AguaClara/sensor_dev/README.md

# sensor_dev
The sensor development team's repo.

## Current Team Members
* Winnie Chan (wc436@cornell.edu)
* Payton Hunter (prh64@cornell.edu)
* Kaleigh Soucy (krs258@cornell.edu)
* Sanjana Uddin (ssu3@cornell.edu)

## Semester Goals
<!---Our goal is to create a lowcost but efficient concentration detector by essentially hijacking cheap endoscopes/borescopes and merging its function with code and physical additions of our own. By designing a mobile application that utilizes image processing and basic equations relating the image values to concentrations, we can both get a visual of what is going on in each level of depth and determine using a threshold value where the sludge blanket begins.--->
Our goal is to create low-cost water quality analyzing sensors for lab and field use. Two projects currently being developed are the sludge judge sampler to measure sludge blanket height in the floc hoppper and the low-cost turbidimeter. The basic function of this sensor is to relate absorbance or image values to concentrations in order to determine the concentration of dissolved organics in the water.

## Links to Reports and Presentations
* Spring 2020
  * Future Mid-Semester Symposium

* Fall 2019
  * [Mid-Semester Symposium](https://docs.google.com/presentation/d/1IKnD7iTeREiuXIxk95GRojf3bocVBwtAz84cADMnMpM/edit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)

* Spring 2019
  * [Final Presentation Video](https://www.youtube.com/watch?v=eXQLOUvBqTo&list=PLhsGtpY8ipdZL4lExJA8KC0zCkaxwfs8R&index=14&t=0s)

  * [Midterm Symposium](https://docs.google.com/presentation/d/19i2A-b2Q4f15zrK7iW6RqBcvtl5FQ7Lq-mFPZDGoYFw/edit?usp=sharing)

  * [Final Presentation](https://docs.google.com/presentation/d/18_G2b-PVCcobUceRZrm6Su0W9RKVEnH4eKmfyDdSLxM/edit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)

  * [Final Manual](https://github.com/AguaClara/sensor_dev/blob/master/Spring%202019/Sensor%20Development%20Spring%202019.md)

* Fall 2018
  * [Final Presentation Video](https://www.youtube.com/watch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)

  * [Midterm Symposium](https://docs.google.com/presentation/d/1lunibmZEZ28jcir-08SKcnAh3Tq5pmKuoBBsQUrALIY/edit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)

  * [Final Presentation](https://docs.google.com/presentation/d/17gbcGkgXVKzlnCITjcyJOvZCZV-m2hfEmijmOgN-dpk/edit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)

  * [Final Manual](https://github.com/AguaClara/sensor_dev/blob/master/2018_fall/Sensor%20Development%20Fall%202018.md)

* Spring 2018
  * [Midterm Symposium](https://docs.google.com/presentation/d/1DQyx87q7LtW5yOaPytrrnAvyGNLM-DLOTYY6XjQVZQw/edit?usp=sharing)

  * [Final Presentation](https://docs.google.com/presentation/d/1z8MEi4Bpe6GwdDxDbs89RpllG_0ilBI8o5UYnoSLq9U/edit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)

  * [Final Manual](https://github.com/AguaClara/sensor_dev/blob/master/manuals/manual_1.md)
