AguaClara/sensor_dev/parser_for_roster/README.txt

1.  please put the file to parse into the current folder

2.  open the terminal and cd into the current folder

3.  use the following command:
        'python3.7 name_organizer.py'

4. follow the prompts

NOTE: you may need to download the xlrd library by inputting the following command
      into the terminal:
        'pip install xlrd'
