AguaClara/sensor_dev/2018_fall/MIA_MAPE.jpg

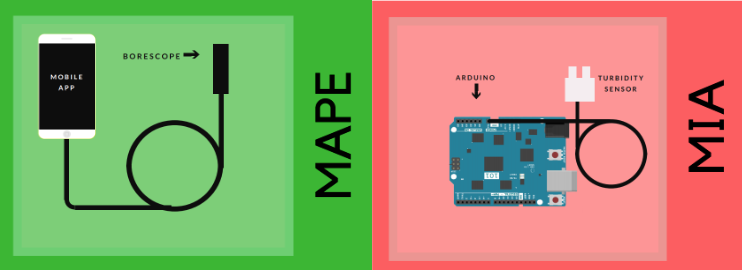
2018_fall/MIA_MAPE.jpg
