AguaClara/sensor_dev/Fall 2019/IR Sample Cell.png

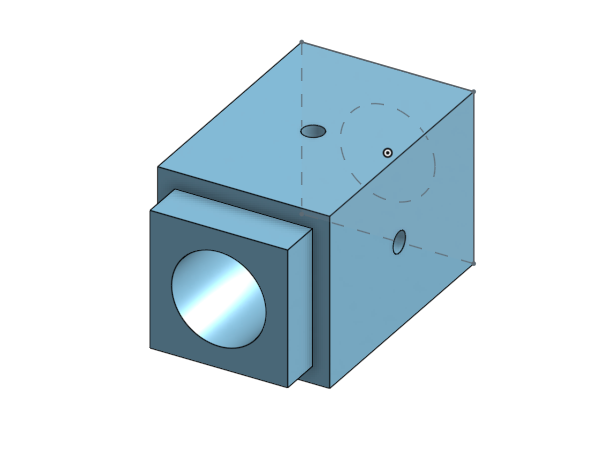
Fall 2019/IR Sample Cell.png
