AguaClara/sensor_dev/Fall 2019/kaolinclayreadings.png

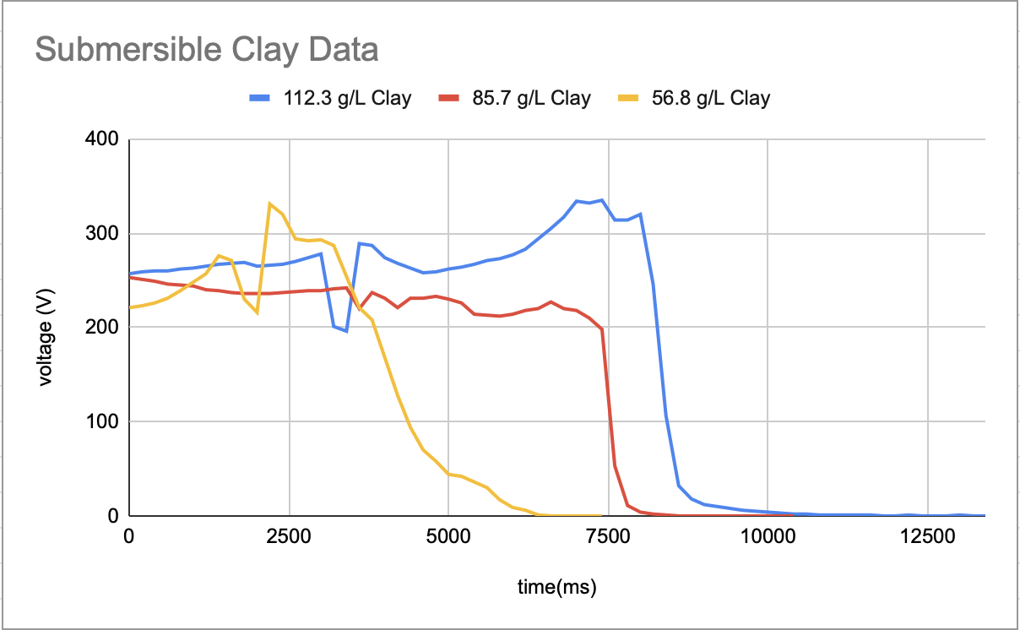
Fall 2019/kaolinclayreadings.png
