AguaClara/sensor_dev/Fall 2019/LEDCircuit.png

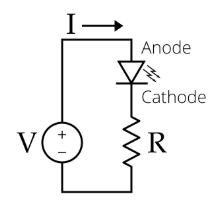
Fall 2019/LEDCircuit.png
