AguaClara/sensor_dev/Fall 2019/oldsubmersibleprototype.png

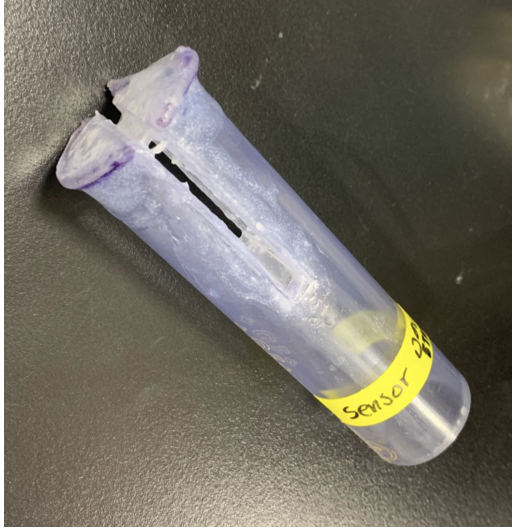
Fall 2019/oldsubmersibleprototype.png
