AguaClara/sensor_dev/Fall 2019/PhototransistorDiagram.png

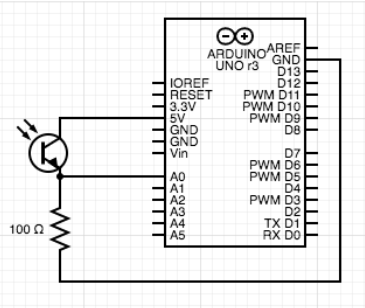
Fall 2019/PhototransistorDiagram.png
