AguaClara/sensor_dev/Fall 2019/RGB Sample Cell.png

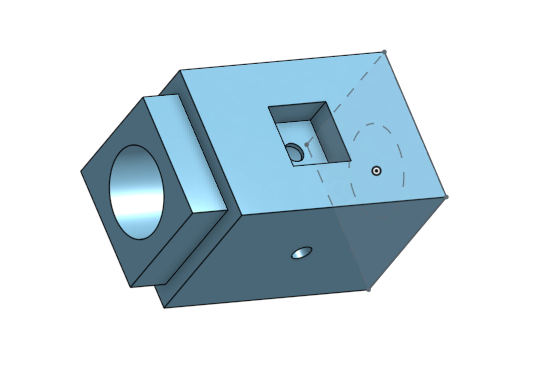
Fall 2019/RGB Sample Cell.png
