AguaClara/sensor_dev/Fall 2019/Sample Cell Top.png

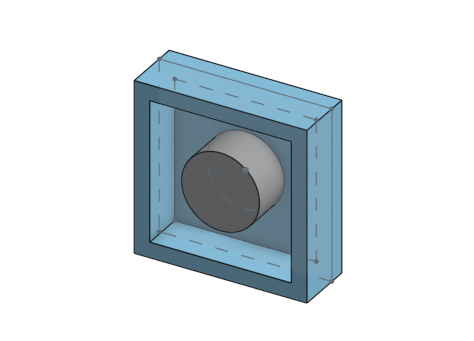
Fall 2019/Sample Cell Top.png
