AguaClara/sensor_dev/Fall 2019/Submersible Sensor.png

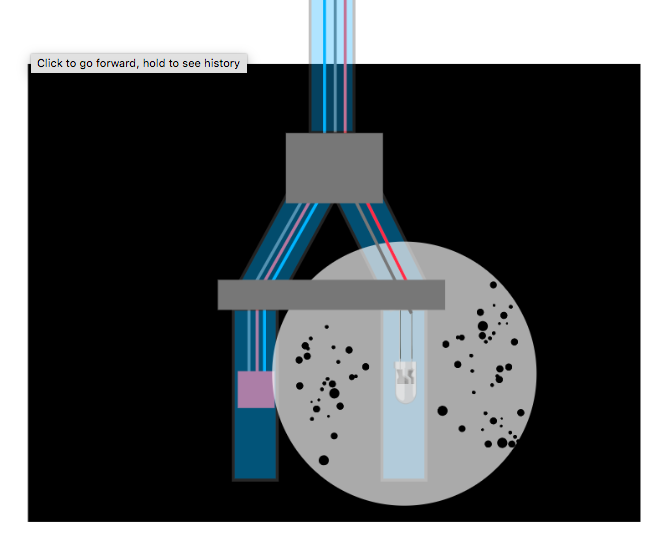
Fall 2019/Submersible Sensor.png
