AguaClara/sensor_dev/Fall 2019/submersibleCAD.png

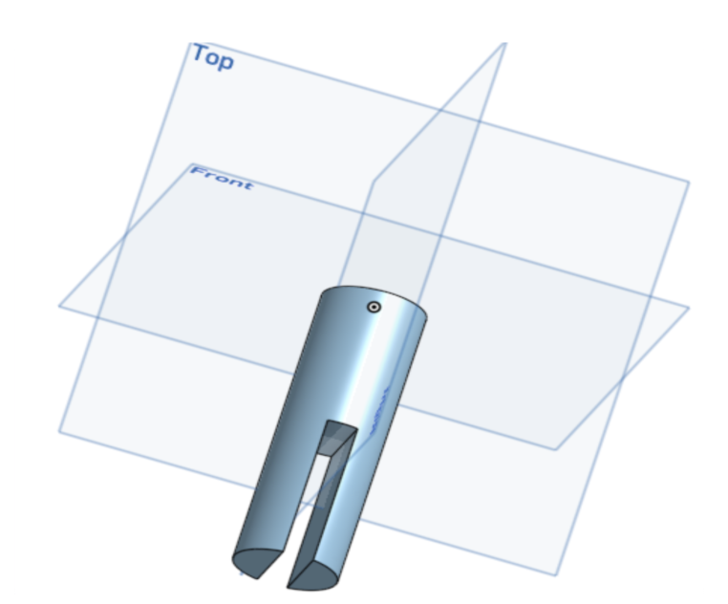
Fall 2019/submersibleCAD.png
