AguaClara/sensor_dev/Fall 2020/500mgLBlue.JPG

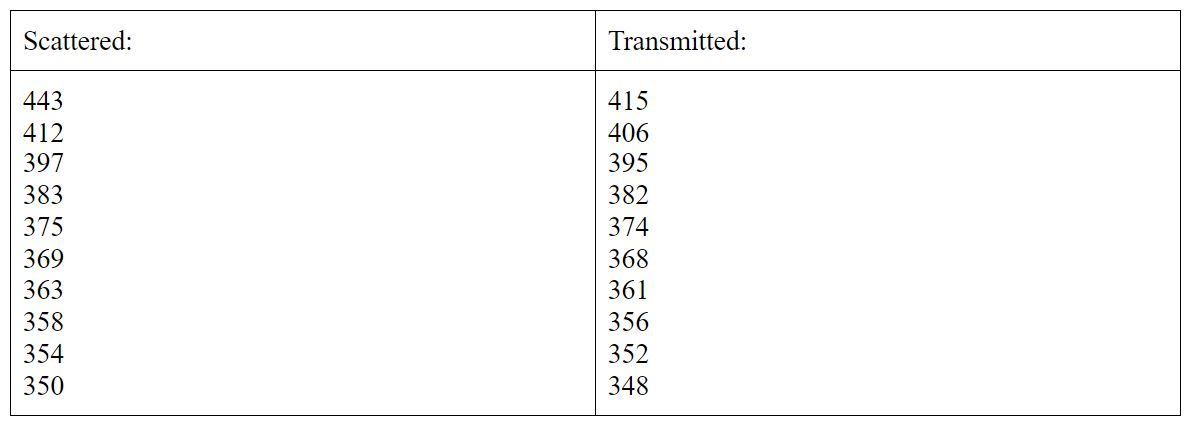
Fall 2020/500mgLBlue.JPG
