AguaClara/sensor_dev/Fall 2020/1000mgLIR.JPG

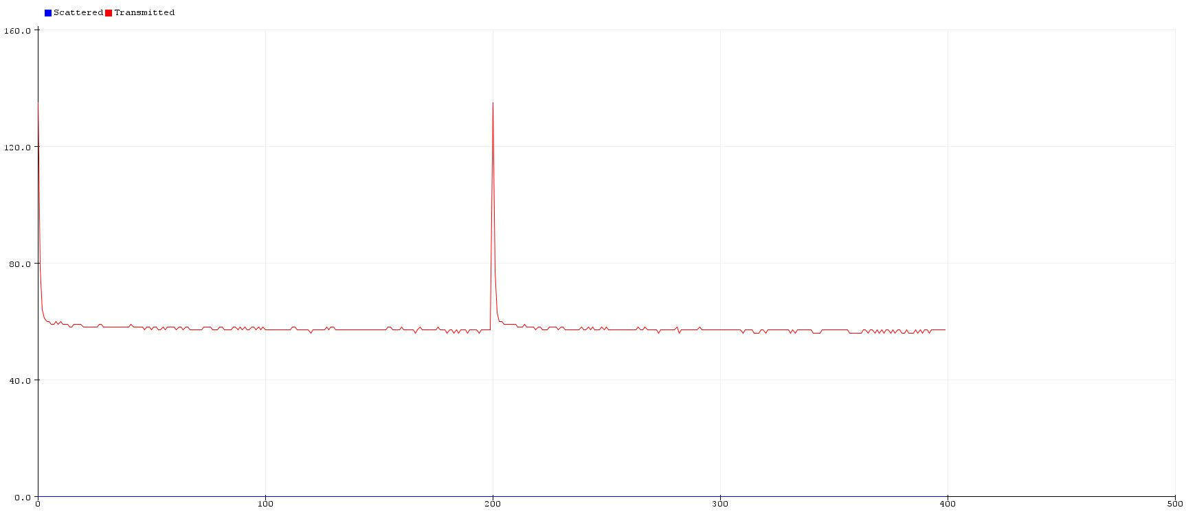
Fall 2020/1000mgLIR.JPG
