AguaClara/sensor_dev/Fall 2020/AguaClara_SludgeJudge.png

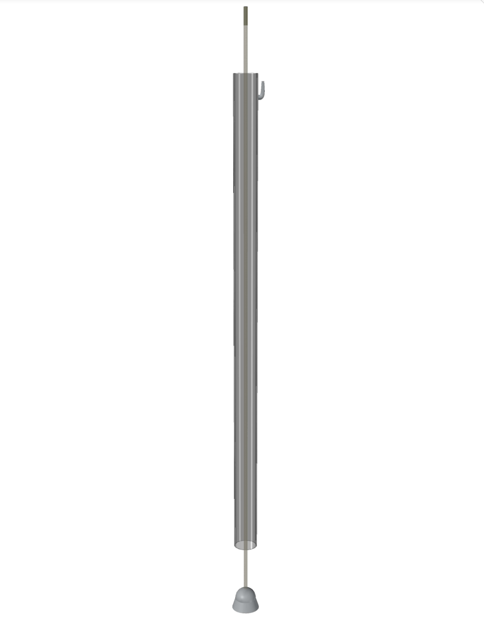
Fall 2020/AguaClara_SludgeJudge.png
