AguaClara/sensor_dev/Fall 2020/IR Sensor Data/0 mgPerL sensor data- report 3-fall 2020.PNG

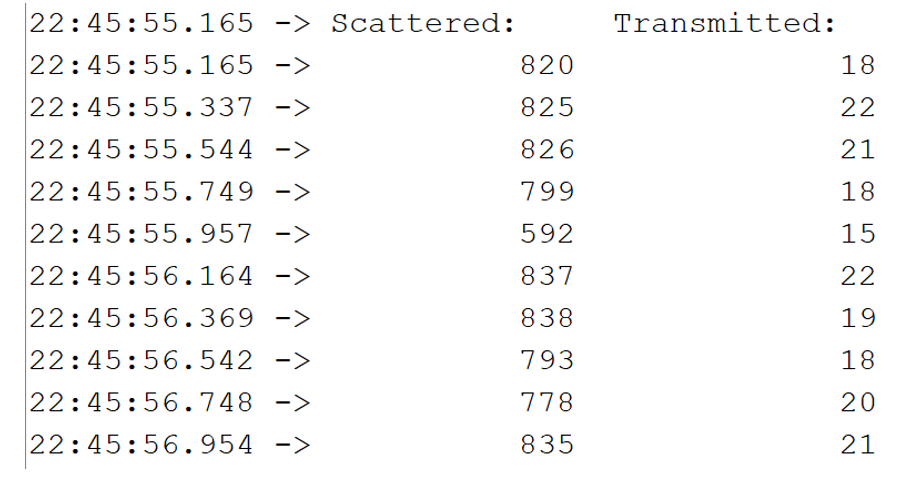
Fall 2020/IR Sensor Data/0 mgPerL sensor data- report 3-fall 2020.PNG
