AguaClara/sensor_dev/Fall 2020/Sensor Circuit.jpg

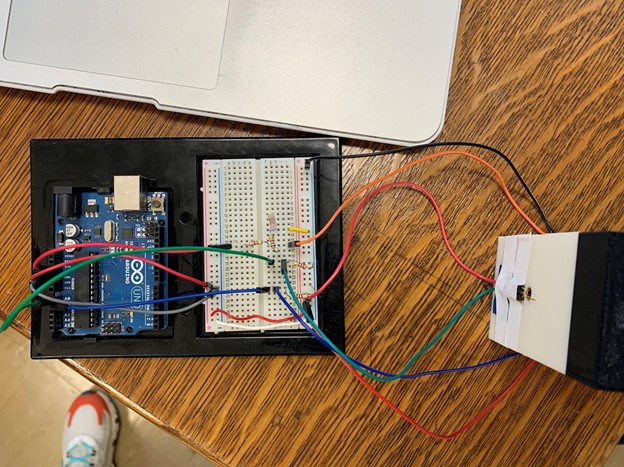
Fall 2020/Sensor Circuit.jpg
