AguaClara/sensor_dev/Fall 2020/Sludge Judge Model Design.PNG

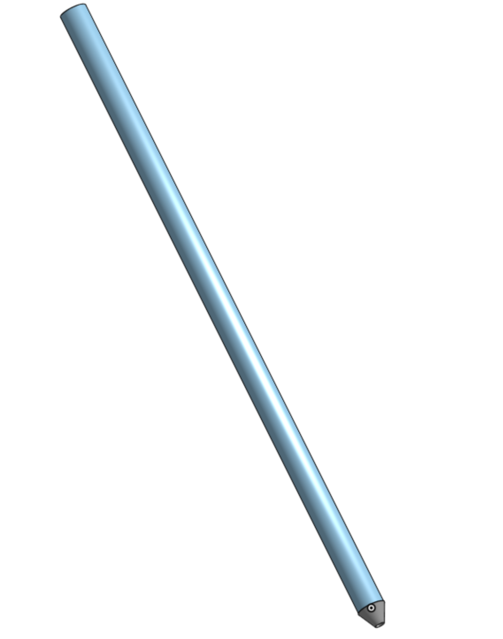
Fall 2020/Sludge Judge Model Design.PNG
