AguaClara/sensor_dev/Newmodelsub.jpg

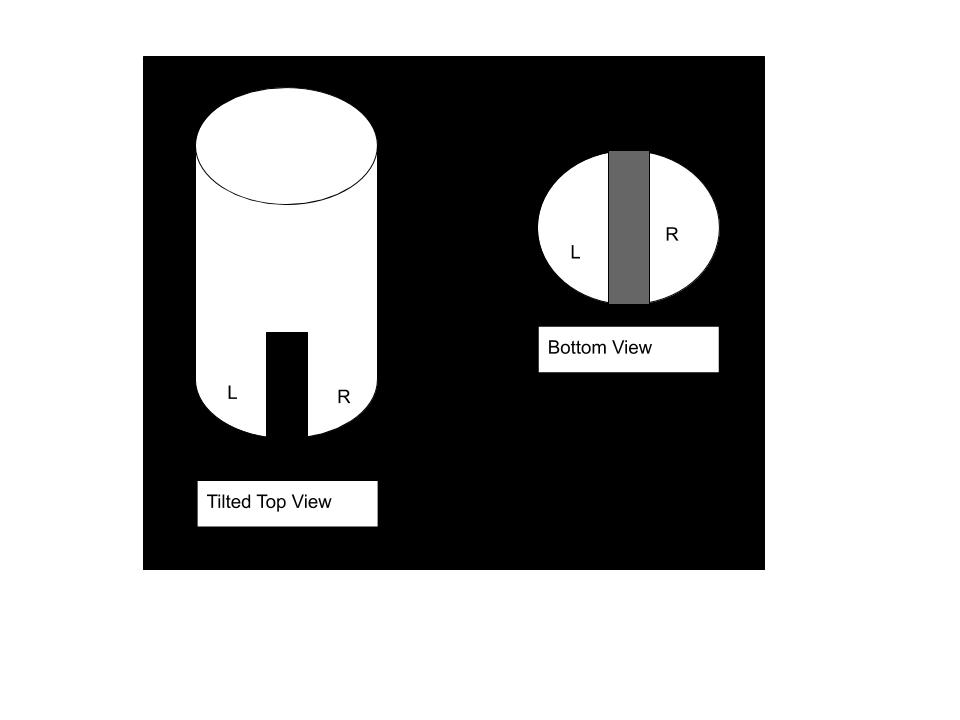
Newmodelsub.jpg
