AguaClara/sensor_dev/Spring 2020/SUBMERSIBLE.png

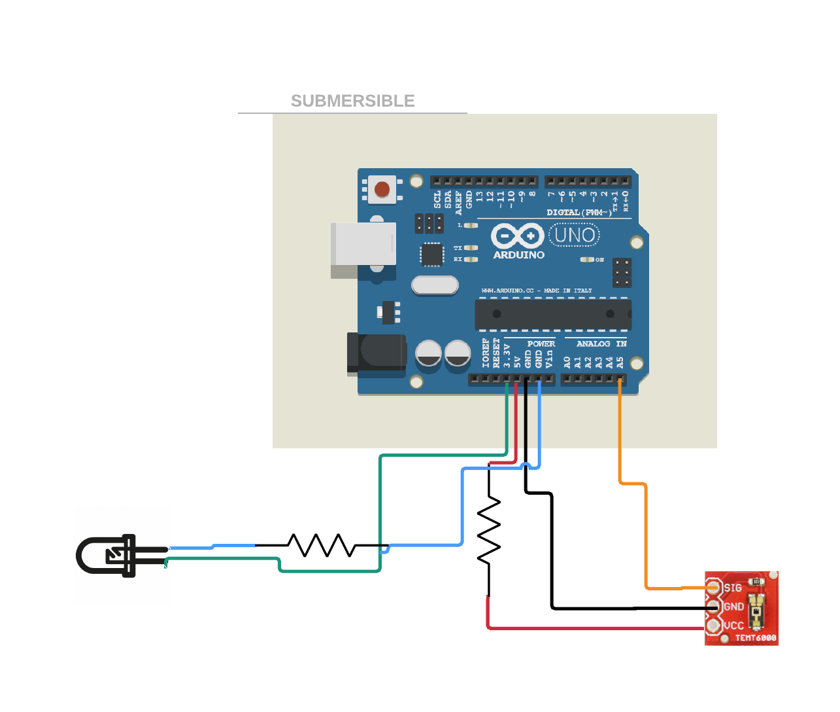
Spring 2020/SUBMERSIBLE.png
