AguaClara/sensor_dev/Fall 2019/DOSensorSetup.jpg

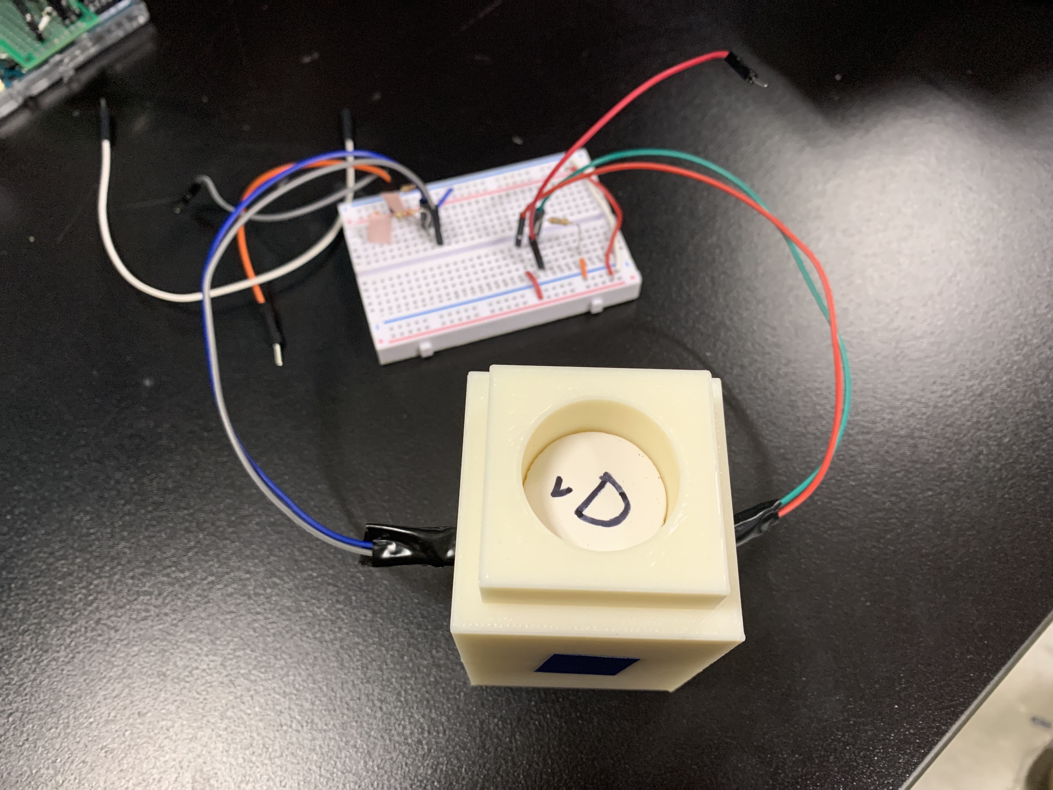
Fall 2019/DOSensorSetup.jpg
