AguaClara/sensor_dev/Fall 2019/submersibleTestingApparatus.png

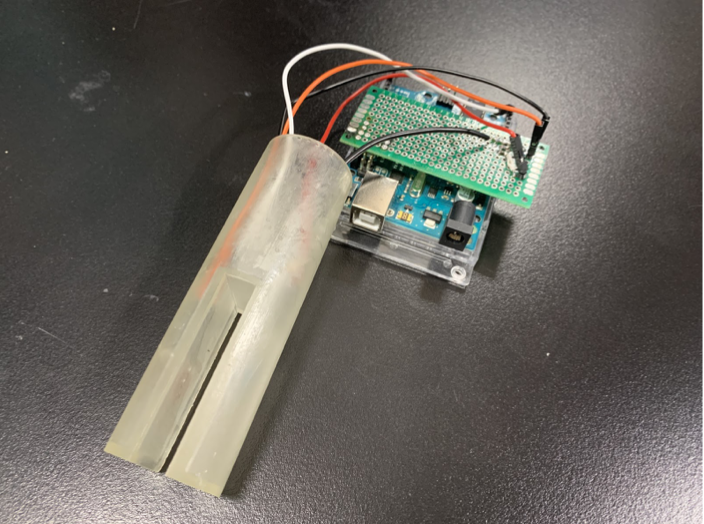
Fall 2019/submersibleTestingApparatus.png
