AguaClara/sensor_dev/(threads)

Thread 10 (2018-02-22):

Test UI[Test the UI for the endoscope sensor]

lois-lee, 2018-02-22:

HannahSi, 2018-05-17:
We currently have two programs: one is run on a computer and streams the computer's own camera or an external camera (the endoscope, connected by USB) while calculating average light intensity of the video frames; the other is an Android app that currently streams feedback from the phone's own camera(s) with constant exposure.

The two functionalities still need to be integrated into the smartphone app. This has been more difficult because the Android libraries cannot directly access external cameras. Instead, we are considering using the OpenCV library (which we will use anyway for image processing) or a third party library (see https://stackoverflow.com/questions/37828376/android-open-external-uvc-camera-instead-hardware-camera) to communicate with the endoscope camera.

HannahSi, 2018-05-17:
As for the GUI, below are functionalities to include:
Need/Strongly want:
- The turbidity of the fluid currently surrounding the endoscope
- A scaled-down live video from the endoscope
- An indication of whether the endoscope has entered the sludge blanket
Want:
- A number-picker/dial for the user to input the depth of the endoscope (known by the expandable ruler used to lower the endoscope)
Wish:
- An option to see a graph of turbidity plotted against depth
- The ability to save such graphs ("turbidity profiles") for each run
- A main menu page where the user can choose to start a new run or view past profiles

HannahSi, 2018-05-17:
As for the GUI, below are functionalities to include:
Need/Strongly want:
- The turbidity of the fluid currently surrounding the endoscope
- A scaled-down live video from the endoscope
- An indication of whether the endoscope has entered the sludge blanket
Want:
- A number-picker/dial for the user to input the depth of the endoscope (known by the expandable ruler used to lower the endoscope)
Wish:
- An option to see a graph of turbidity plotted against depth
- The ability to save such graphs ("turbidity profiles") for each run
- A main menu page where the user can choose to start a new run or view past profiles

HannahSi, 2019-02-07:
@ll678 I think my first comment in this issue is a good explanation of progress and next steps I talked about today. Basically, the mobile app still needs to
1) Access and display images from an external camera, i.e. the endoscope
     * Maybe use OpenCV, which we used to access the camera in the Endoscope Pilot Code project
2) Process those images for average light intensity
     * See the [averageLight function](https://github.com/AguaClara/sensor_dev/blob/master/code/Endoscope%20Pilot%20Code/EndoscopeFrame.java#L72-L90) in EndoscopeFrame.java in the Endoscope Pilot Code project)

I'm currently working on documenting the mobile app code. When I'm done, would you like me to send it to you or contribute it to the repository?

ll678, 2019-02-07:
@HannahSi  You can contribute the documentation to the repository. Thank you!

Thread 3 (2018-02-22):

Fabrication [fabricate the parts necessary for the turbidity sensor and the endoscope sensor]

lois-lee, 2018-02-22:
[fabricate the parts necessary for the turbidity sensor and the endoscope sensor]

lois-lee, 2018-02-27:
We've been working so far on waterproofing the turbidity sensor by sealing PVC to the top of the sensor and then using more flexible tubing for the wiring.

For the Borescope, we've realized that the design will depend heavily on a lot of variables which have to be tested, so we have to test it in an environment similar to the floc hopper and then begin fabrication.

hs649, 2018-03-01:
The prototype of the waterproof casing is near finished.
The variables include the reflectivity of the container and of the sediment. It would be helpful to know these characteristics of the floc hopper, but for now our goal is to gauge the consistency of the borescope feedback while those factors are eliminated as much as possible, such as with a very large and/or matte container and dark sediment.

HannahSi, 2018-03-06:
Forgot to post this last week. We finished fabrication of the turbidity sensor casing, shown in the picture attached. For some reason though, when we tested the encased and uncased sensors on Thursday, neither seemed to working properly--their values didn't fluctuate enough with changes in light. We're going to test and troubleshoot the uncased turbidity sensor first to see if it's poor connections or something else.

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

vsrilekha, 2018-05-17:
We have discontinued using this analog turbidity sensor and have opted to use an LED instead.

Closed 2018-05-17.

Thread 4 (2018-02-22):

Programming [programming in C for the turbidity sensor and programming in Java for the mobile/website app]

lois-lee, 2018-02-22:

lois-lee, 2018-02-27:
Preliminary coding for the turbidity sensor is finished, we just need to figure out a reliable relation and then test.

Coding for the mobile application is in the works. We are using OpenCV.

hs649, 2018-02-28:
I installed OpenCV for Java on my computer and am having trouble adding the library's "external JAR" to Eclipse. I was hoping to write a basic program for computing average grayscale to help with testing the precision of the endoscope images. If we're testing this week, we may have to find another temporary method of computing this.

hs649, 2018-03-01:
The OpenCV library is now working in Eclipse! Currently looking into ways to collect and display camera feedback without involving too much third party software.

HannahSi, 2018-03-15:
Just committed Java code for viewing the endoscope video in a computer and obtaining its camera settings. I tried to modify certain settings so that we can hold the gain and exposure constant, but so far it has been unsuccessful. Maybe it's a deficiency of the Java OpenCV library, maybe I need to use another part of it.

HannahSi, 2018-03-17:
It seems like OpenCV can't change the camera parameters for this USB camera (perhaps because the camera is not advanced enough; it also doesn't work with my computer's built-in webcam). However, when I search "Java set camera parameters", there seems to be more documentation for doing so with the Java Android libraries. So maybe we should try figuring it out directly through app programming?
Also, I wrote some code that averages the light intensity value of every pixel in the camera image. Next step is to see how sensitive it is to small spots of light against a black background (if it's not sensitive enough we could probably square/exponentiate the values).

HannahSi, 2018-03-20:
Came across this error while running the endoscope code: `Exception in thread "AWT-EventQueue-0" java.lang.IllegalArgumentException: Width (0) and height (0) must be > 0`. It seems there are two cases in which this occurs:
1. The camera could not be found. This should be accompanied by an error at the very beginning saying `OpenCV: out device of bound (0-0): 1 \ OpenCV: camera failed to properly initialize!`. Since I could see that my computer itself could detect the USB camera ( > About This Mac > System Report > USB), I restarted my computer and the problem was resolved (mostly, see next case).
2. The error also occurs if the endoscope image is completely black. We may not be able to achieve full blackness with the LEDs on, but if this is an issue hopefully we can correct it programmatically.

Closed 2018-05-17.

Thread 5 (2018-02-22):

Testing Function [testing the code's function for turbidity sensor]

lois-lee, 2018-02-22:

lois-lee, 2018-03-08:
The sensor's are not fluctuating as much as they should be, so we need to troubleshoot the sensor. We're not sure if they are broken or if it's a connection problem.

Closed 2018-05-17.

Thread 6 (2018-02-22):

UI [make a user interface for the turbidity sensor using a digital screen]

lois-lee, 2018-02-22:

lois-lee, 2018-03-16:
added some code using liquid crystal display library from arduino for a possible interface.

Thread 12 (2018-02-27):

Github Issues Check #1

caseyching13, 2018-02-27:
See the rubric that was shared with you earlier in the semester for your Team's grade.

-Good detailed logbook on Sensor Dev’s website. Would it be possible to try to switch over to Github to track progress as opposed to documenting it on the website?

The following should be on Github issues:
-Problems/questions that come up
-Discussion on said problems (it would allow Ethan and Monroe to give feedback and to see your team’s progress)
-Pictures! I would love to see how the Arduino board is coming along
-Make sure all team members are participating on Github!
-Don’t forget to track meetings on Github
-Please incorporate suggestions into future Github usage
-The next Github issues check will be in 2 weeks!

Closed 2018-05-17.

Thread 15 (2018-03-21):

Github Issues Check #2

caseyching13, 2018-03-21:
See the rubric that was shared with you earlier in the semester for your Team's grade.

-Github issues are thorough! I like how questions are posed and subsequently answered as the problems are figured out
-Good use of pictures
-Is there any reason why @vsrilekha isn’t participating on Github?
-The team can close issues as necessary (including the meeting #1 and Github issues check #1)
-Huge improvement from Issues check #1!

-Next Issues check will be after Spring Break
-Feel free to contact me with questions!

Closed 2018-05-17.

Thread 17 (2018-04-11):

Light gain issue resolved

lois-lee, 2018-04-11:
When we talked to Monroe we were trying to see if we could adjust and turn off light gain. We don't think it's resolvable by programming so we're going to cover one half of it up and then use it as a control to manually determine the light gain factor

HannahSi, 2018-05-16:
The light gain issue is actually close to being resolved programmatically! The Android camera library used in the Android app code (see sensor_dev/code/AguaClara Turbidity) is able to set a constant exposure compensation for the front and rear cameras on the Android phone we tested on. We just need to find a way to access the endoscope camera through the app and make the same parameter change.

Thread 20 (2018-04-24):

Holes on DoubleHinge CAD

vsrilekha, 2018-04-24:
Having trouble lofting the holes, don't appear to be mirroring correctly

Closed 2018-05-17.

Thread 21 (2018-05-03):

MAPE Extension Design

HannahSi, 2018-05-03:
The purpose of MAPE turbidity sensor extension is to hold the non-reflective material in front of the camera lens without compromising the diffusion of particles in front of the lens. Our initial plan was to hold the material at the end of three prongs attached to the endoscope by a shaft collar, but for sturdiness, appearance, and ease of fabrication we have changed to a design involving two plates separated by standoffs. See next comments for details.

HannahSi, 2018-05-03:
Below is the design with prongs we started to implement. We chose prongs made of tempered steel for durability but did not include the shaft collar yet, because we were uncertain of how to securely attach the prongs to a metal collar. (A soldered connection would not be too weak. We considered welding but preferred this to be a last resort because of the skills and experience required.) See the "drawings" folder in our repository for a CAD rendering of this design.

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

HannahSi, 2018-05-04:
Below is the design we are currently fabricating with two plates and standoffs. Details to come tomorrow.

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

HannahSi, 2018-05-08:
Sorry I never finished posting this last week. Below is the design with two plates separated by standoffs. The plate in front of the endoscope lens serves the hold the nonreflective material, while the other plate serves to secure the entire contraption to the endoscope. We are using an endmill to cut a path into the latter plate so that the cable can pass through, and the plate can be glued to flush the base of the endoscope. Hopefully we'll have pictures of the finished extension later today.

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
<img src="https://user-images.githubusercontent.com/35944490/39766935-8309269e-52b3-11e8-9e6f-dd5852793737.jpg height=300>

HannahSi, 2018-05-08:
Fabrication notes on the standoff design:

- This design requires at least 4 standoffs, depending on their length, each with a female and male end. Two need to be cut about 1 cm from the ends to obtain just the female and male ends, and the other two are placed in between the two plates (they are the main standoffs). The latter are secured by screwing into or being screwed into the shortened female and male ends. (Alternatively, the former two can be replaced with screws and bolts if you can find the right size.)
- Next time use PVC or other plastic instead of metal for the two plates. It would be cheaper, and perhaps the plates would not become so hot when cutting.
- The standoffs we used had male ends of 5/32".
- Instead of using an endmill to cut a slot for the endoscope cable, we simply drilled a hole, then cut out the slot with a bandsaw. The diameter of the endoscope cable is 11/64".

HannahSi, 2018-05-09:
To calculate the dimensions of the plate, we first determined the optimal distance of the endoscope from the non-reflective material. This distance should minimize the area of material required (thus minimizing the overall diameter of the sensor) as well as the light reflected from the material. (A greater distance decreases light reflected but increases viewing area.) For our endoscope and with matte rubber as the non-reflective material, we estimated 1.5 cm.

We then used this distance and the FOV (field of view) angle of the endoscope, 60º, to calculate the width of the viewing area: 1.5 / √3 * 2 = 1.732 cm.

Adding extra length on two sides for the standoffs and a few millimeters of buffer space, we chose to cut a plate of 3.5 x 2 cm to hold the non-reflective material. The plate attached to the base of the endoscope has the same dimensions for symmetry.

HannahSi, 2018-05-09:
We're currently trying to figure out the best way to attach the base of the endoscope to the metal plate. We waiting on a silicone sealant we used to cure (harden), but it's white and thick and looks quite messy. Our research advisor suggested applying a ring of hot glue around the metal plate as a secure and more attractive sealing method. Sketch to come.

HannahSi, 2018-05-11:
I think any way of adhering the endoscope base to the metal as shown above (with the base sitting on the metal) is prone to detachment. Right now, the metal is hot glued around the body of the endoscope, which is probably a more secure method. This required first drilling a hole large enough for the whole endoscope to slide through.

HannahSi, 2018-05-17:
The MAPE extension has been finished, but it can be improved so that the endoscope is held more perpendicular to the non-reflective material. Right now, it is slightly angled because the hole in top metal plate was 1/16" too large, and the hot glue is not completely secure/rigid, so the endoscope is able to tilt. The problem can be solved with a smaller hole, perhaps thicker metal/PVC plates, and/or shorter distance between the two metal plates (so the tilt is less perceptible).

<img src="https://user-images.githubusercontent.com/35944490/40208396-7d711eb6-5a07-11e8-98ca-4c1ebd0df685.jpg" height=300">

Closed 2018-05-17.

Thread 22 (2018-05-17):

MIA Sensor [Future Work]

vsrilekha, 2018-05-17:
The design for the MIA sensor has changed. We are no longer using the analog turbidity sensor and are looking into using a LED and a light sensor. We used a similar setup for the fluidized bed solids detector last semester. The idea is to measure voltage output from the sensor and convert the voltage readings to absorbance. Beer's Law could then be used to study the linear relationship between concentration and absorbance. Tests would need to be run determine the exact relationship and a curve would need to be fitted. This relationship could then be programmed into the microcontroller (the Arduino) and used to output turbidity values.

vsrilekha, 2018-05-17:
Currently, we have written the code for the LED and light sensor. The light sensor has been wired to the microcontroller. Future work would include designing and fabricating a waterproof case for the light sensor and LED. We were exploring options of flexible tubing for the wires, similar to microbore tubing. The casing for the sensor needs to be clear, so that the sensor can detect any changes in light. Also the LED and sensor need to placed at set distance away from each other.

Thread 25 (2019-02-27):

RA Comments Fab Manual 1

mailemccann, 2019-02-27:
Abstract-
Include other aspects of the objective- you're not just trying to create sensors, but create sensors that are easily accessible- cost, materials, etc. Also, you don't need to include so much about previous semesters- that can go in previous work. Focus on what you subteam is working on this semester. You can just say: "In Spring 2019, the team worked on the in-lab fluidized bed solid detector and finalized the design for the sludge blanket detector...etc" and include some details about the differences between the two.

Introduction-
Again, a lot of this can go in previous work instead of intro. Emphasize why sensor development exists, and what the overarching goals are. Turbidimeters have already been invented- what does your team aim to accomplish with the sensors that you are designing.

Previous Work-
This is very comprehensive! I still think you can include the last two paragraphs of the Introduction in this section, however. Also, you don't define what an endoscope is in Intro or Previous Work. I think you should explain that briefly. You guys use a lot of super technical terminology in the last paragraph as well, which could be work briefly elaborating on. Maybe explain the purpose of a photodiode and how that allows for light detection, in a sentence or so.

Methods-
You mention calibration testing in earlier sections, but don't explicitly describe the idea of a calibration curve. You could add a few sentences when you discuss calibration in Previous Work, but maybe include a short descriptor in Methods as well. Also, instead of apparatus, maybe say "HRS sensor", as you reference sensor in the first step but it took me a second to put together that it was the HRS sensor that you were describing.

mailemccann, 2019-02-28:
Oops, posted before I had finished typing. The Fabrication details section is extremely comprehensive and I think its a really great start. Maybe add a sentence explaining what certain terms are, as the majority of the people reading won't have a circuits background, eg: unity gain, op amp. I can't see your drawings on Github to comment on, also. The special components section also might read well as a table, where you have columns for component, description, dimensions/specs, where to buy. Something to consider. Overall this was really excellent, super readable (even for someone with no EE background like me), and very comprehensive. Lets meet next week to discuss my comments and plans for the rest of the semester!

mailemccann, 2019-02-28:
Also I can't find Sonu on Github to assign the issue. If you see this, what's your Github name?

lois-lee, 2019-02-28:
Thanks for the comments! Also I just messaged Sonu about her username and I'll also link this issue to her. Thanks again!!

sidneylok, 2019-03-07:
Hey guys! Just wanted to add that you should have a bibliography/references section to compile all of citations for the reports and papers you referenced in your lit review and previous work sections. I didn't grade this in your first manual because I'm not sure if it was made clear enough that Fab teams need to include this, but you will be graded on it next time so be sure to include it in your next iteration! Thanks :)

Thread 27 (2019-03-28):

RA Comments Fab Manual #2

mailemccann, 2019-03-28:
Yay!!! You made some of my suggestions!! I think the introduction, abstract, and previous work flows really well. Here are some of my comments:

- In introduction, say "Professor Monroe Weber- Shirk" instead of just Monroe
- Under methods, I think you could explain what a calibration curve is and what the objective of creating it might be, even though you briefly mention it earlier in the report
- Fabrication details
-- Since you're underway with fabrication, you can definitely go more in detail here. You mention waterproofing is an issue for the submersible sensor, so maybe include pictures or CAD diagrams of where the issues may arise in the apparatus. This is especially useful for future teams to look back on so they can better understand the issues you guys had and how you fixed them!
- Special Components is super comprehensive!!
- For experimental methods, you COULD consider making this an instructional list instead of paragraph form, up to you though, I think its readable as is
- Again, dope writing skills :)

Thread 29 (2019-11-07):

Biweekly Discussion: November 8, 2019

SonuKapoor9, 2019-11-07:
Goals:
- Figure out issues for the RGB Sensor
- Submersible Update

To-Dos:
- Saul: email the RPL office to find what is the most transparent (11.07.19)
- Rishik: Do the Harlem Shake (11.06.19 ~20:45PM)

SonuKapoor9, 2019-11-07:
@

Thread 30 (2019-11-19):

Biweekly Discussion: November 19th, 2019

Saul-Bernaber, 2019-11-19:
Goals:

Figure out issues for the RGB Sensor (continuing)
Test and established sensors with submersible casing (3D Printed)
Figure out testing apparatus (find a "sludge blanket" to test with)(could ask UASB)
Finding an extendable pole (continuing)
To-Dos:

Week of Nov. 19 -

Test waterproof of submersible and install semi-permanent sensors
Start experiments in order to detect sludge blanket
Troubleshoot RGB Sensor (check color vs colored light)
