AguaClara/sensor_dev/(commit log)

2018-09-25 Rename Sensor_Development_FA_18.md to Sensor Development Fall 2018.md
2018-10-21 Update Sensor Development Fall 2018.md
2019-02-20 Create Spring 2019
2019-03-02 Update Sensor Development Spring 2019.md
2019-04-01 Update Sensor Development Spring 2019_manual_2_comments.md
2019-04-09 Rename Spring 2019/Sensor Development Spring 2019.md to Draft
2019-04-09 Rename Sensor Development Spring 2019_manual_2_comments.md to Sensor Development Spring 2019
2019-04-09 Update Sensor Development Spring 2019
2019-04-09 Rename Sensor Development Spring 2019 to Sensor Development Spring 2019.md
2019-04-13 New MAPE Code
    [jconfig.txt]
2020-03-06 submersible schematic
2020-03-07 Rename SensorDev2020Spring.ipynb to Spring 2020/SensorDev2020Spring.ipynb
2020-03-09 IR sensor code_1
2020-12-07 Create IR Sensor Data
